papayapeter/nixie-clock/README.md

# nixie-clock
a nixie clock built around 4 IN-2 tubes and an INS-1 dot

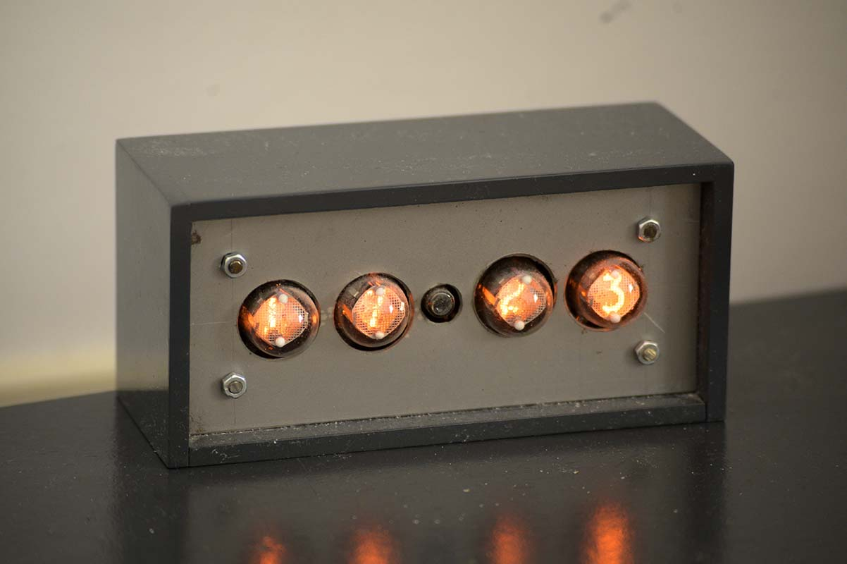
[picture p1: doc/_DSC0836.jpg]
front


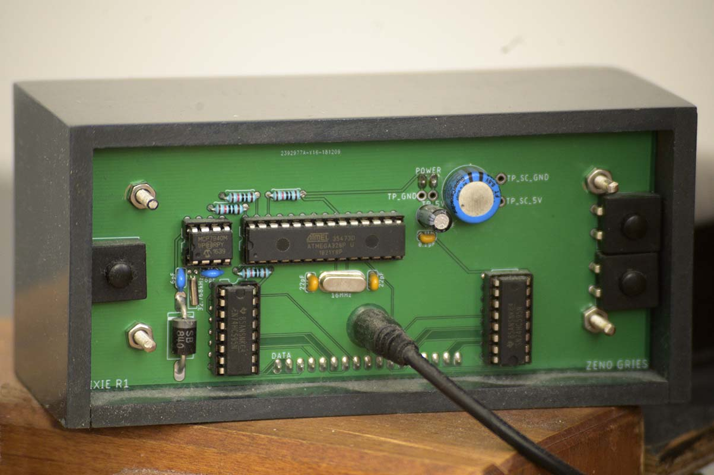
[picture p2: doc/_DSC0846.jpg]
back
