papayapeter/nixie-clock/eagle/HighVBoard_01.brd

## EAGLE design eagle/HighVBoard_01.brd (2019-07-09)

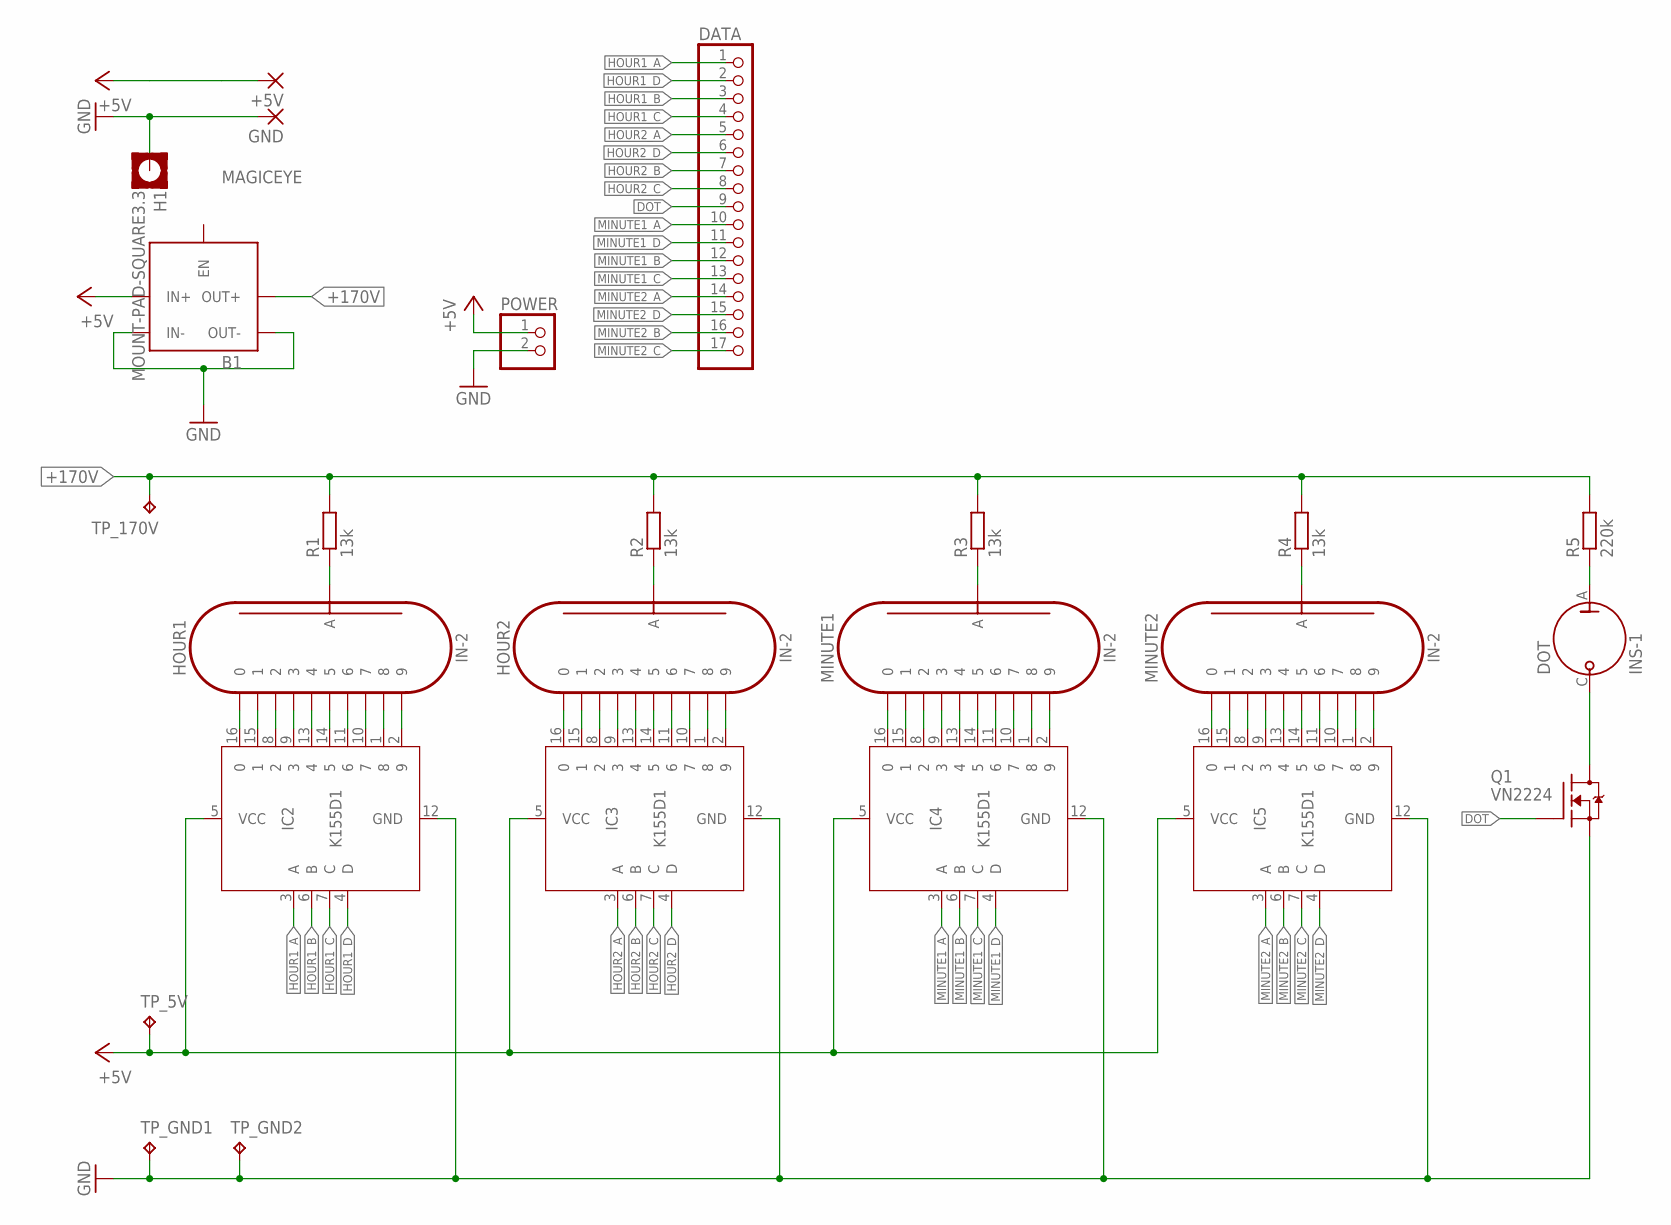
[picture p3: schematic HighVBoard_01.sch]

Parts:
+5V: 2,15/1,0
B1: MAGICEYE
DATA: PINHD-1X17; 1X17
DOT: INS-1
GND: 2,15/1,0
H1: MOUNT-PAD-SQUARE3.3; 3,3-PAD-SQUARE
HOUR1, HOUR2: IN-2
IC2, IC3, IC4, IC5: K155D1; DIL16
MINUTE1, MINUTE2: IN-2
POWER: PINHD-1X2; 1X02
Q1: VN2224; TO92
R1, R2, R3, R4: 13k; 0207/10
R5: 220k; 0207/10
TP_5V, TP_170V: TPPAD1-13; P1-13
TP_GND1, TP_GND2: TPPAD1-13; P1-13

Connections:
+5V: +5V.1, B1.IN+, IC2.5 (VCC), IC3.5 (VCC), IC4.5 (VCC), IC5.5 (VCC), POWER.1, TP_5V.TP
+170V: B1.OUT+, R1.2, R2.2, R3.2, R4.2, R5.2, TP_170V.TP
DOT: DATA.9, Q1.2 (G)
GND: B1.IN-, B1.OUT-, GND.1, H1.B3,3, IC2.12 (GND), IC3.12 (GND), IC4.12 (GND), IC5.12 (GND), POWER.2, Q1.1 (S), TP_GND1.TP, TP_GND2.TP
HOUR1_A: DATA.1, IC2.3 (A)
HOUR1_B: DATA.3, IC2.6 (B)
HOUR1_C: DATA.4, IC2.7 (C)
HOUR1_D: DATA.2, IC2.4 (D)
HOUR2_A: DATA.5, IC3.3 (A)
HOUR2_B: DATA.7, IC3.6 (B)
HOUR2_C: DATA.8, IC3.7 (C)
HOUR2_D: DATA.6, IC3.4 (D)
MINUTE1_A: DATA.10, IC4.3 (A)
MINUTE1_B: DATA.12, IC4.6 (B)
MINUTE1_C: DATA.13, IC4.7 (C)
MINUTE1_D: DATA.11, IC4.4 (D)
MINUTE2_A: DATA.14, IC5.3 (A)
MINUTE2_B: DATA.16, IC5.6 (B)
MINUTE2_C: DATA.17, IC5.7 (C)
MINUTE2_D: DATA.15, IC5.4 (D)
unnamed: DOT.C, Q1.3 (D)
unnamed: HOUR1.0, IC2.16 (0)
unnamed: HOUR1.1, IC2.15 (1)
unnamed: HOUR1.2, IC2.8 (2)
unnamed: HOUR1.3, IC2.9 (3)
unnamed: HOUR1.4, IC2.13 (4)
unnamed: HOUR1.5, IC2.14 (5)
unnamed: HOUR1.6, IC2.11 (6)
unnamed: HOUR1.7, IC2.10 (7)
unnamed: HOUR1.8, IC2.1 (8)
unnamed: HOUR1.9, IC2.2 (9)
unnamed: HOUR1.A, R1.1
unnamed: HOUR2.0, IC3.16 (0)
unnamed: HOUR2.1, IC3.15 (1)
unnamed: HOUR2.2, IC3.8 (2)
unnamed: HOUR2.3, IC3.9 (3)
unnamed: HOUR2.4, IC3.13 (4)
unnamed: HOUR2.5, IC3.14 (5)
unnamed: HOUR2.6, IC3.11 (6)
unnamed: HOUR2.7, IC3.10 (7)
unnamed: HOUR2.8, IC3.1 (8)
unnamed: HOUR2.9, IC3.2 (9)
unnamed: HOUR2.A, R2.1
unnamed: IC4.16 (0), MINUTE1.0
unnamed: IC4.15 (1), MINUTE1.1
unnamed: IC4.8 (2), MINUTE1.2
unnamed: IC4.9 (3), MINUTE1.3
unnamed: IC4.13 (4), MINUTE1.4
unnamed: IC4.14 (5), MINUTE1.5
unnamed: IC4.11 (6), MINUTE1.6
unnamed: IC4.10 (7), MINUTE1.7
unnamed: IC4.1 (8), MINUTE1.8
unnamed: IC4.2 (9), MINUTE1.9
unnamed: MINUTE1.A, R3.1
unnamed: IC5.16 (0), MINUTE2.0
unnamed: IC5.15 (1), MINUTE2.1
unnamed: IC5.8 (2), MINUTE2.2
unnamed: IC5.9 (3), MINUTE2.3
unnamed: IC5.13 (4), MINUTE2.4
unnamed: IC5.14 (5), MINUTE2.5
unnamed: IC5.11 (6), MINUTE2.6
unnamed: IC5.10 (7), MINUTE2.7
unnamed: IC5.1 (8), MINUTE2.8
unnamed: IC5.2 (9), MINUTE2.9
unnamed: MINUTE2.A, R4.1
unnamed: DOT.A, R5.1

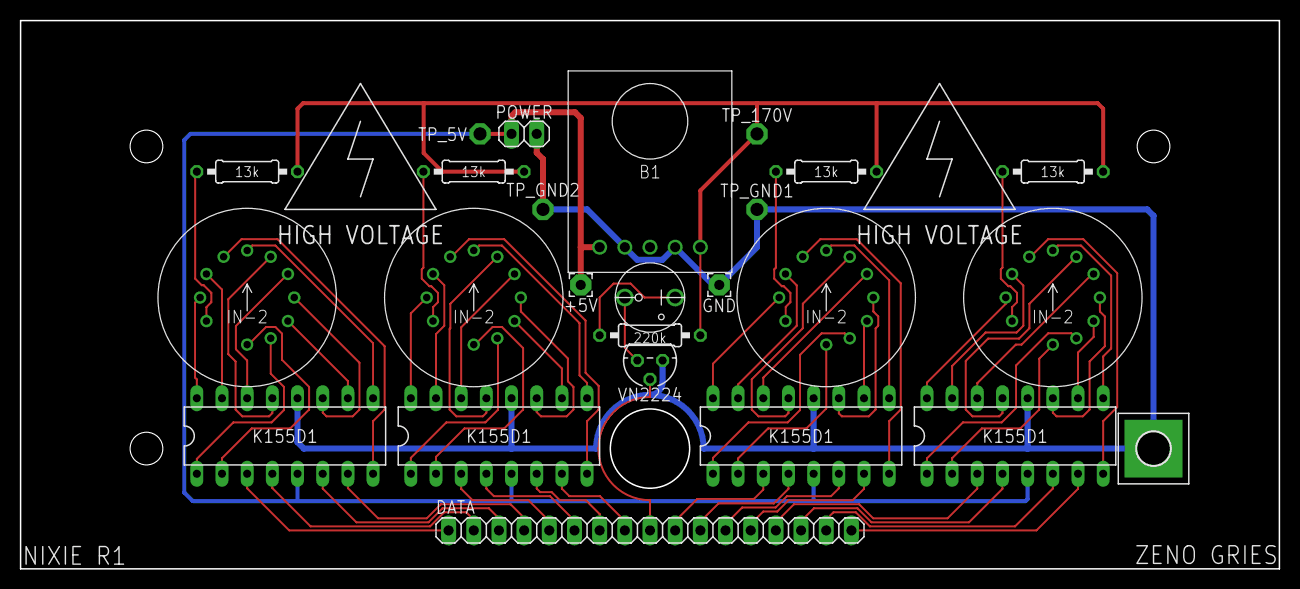
[picture p4: board HighVBoard_01.brd from above]

Board: 2 copper layers, 127.0 x 55.3 mm, 25 parts (0 on the bottom side), 66 nets.
