papayapeter/nixie-clock/eagle/LowVBoard_01.brd

## EAGLE design eagle/LowVBoard_01.brd (2019-07-09)

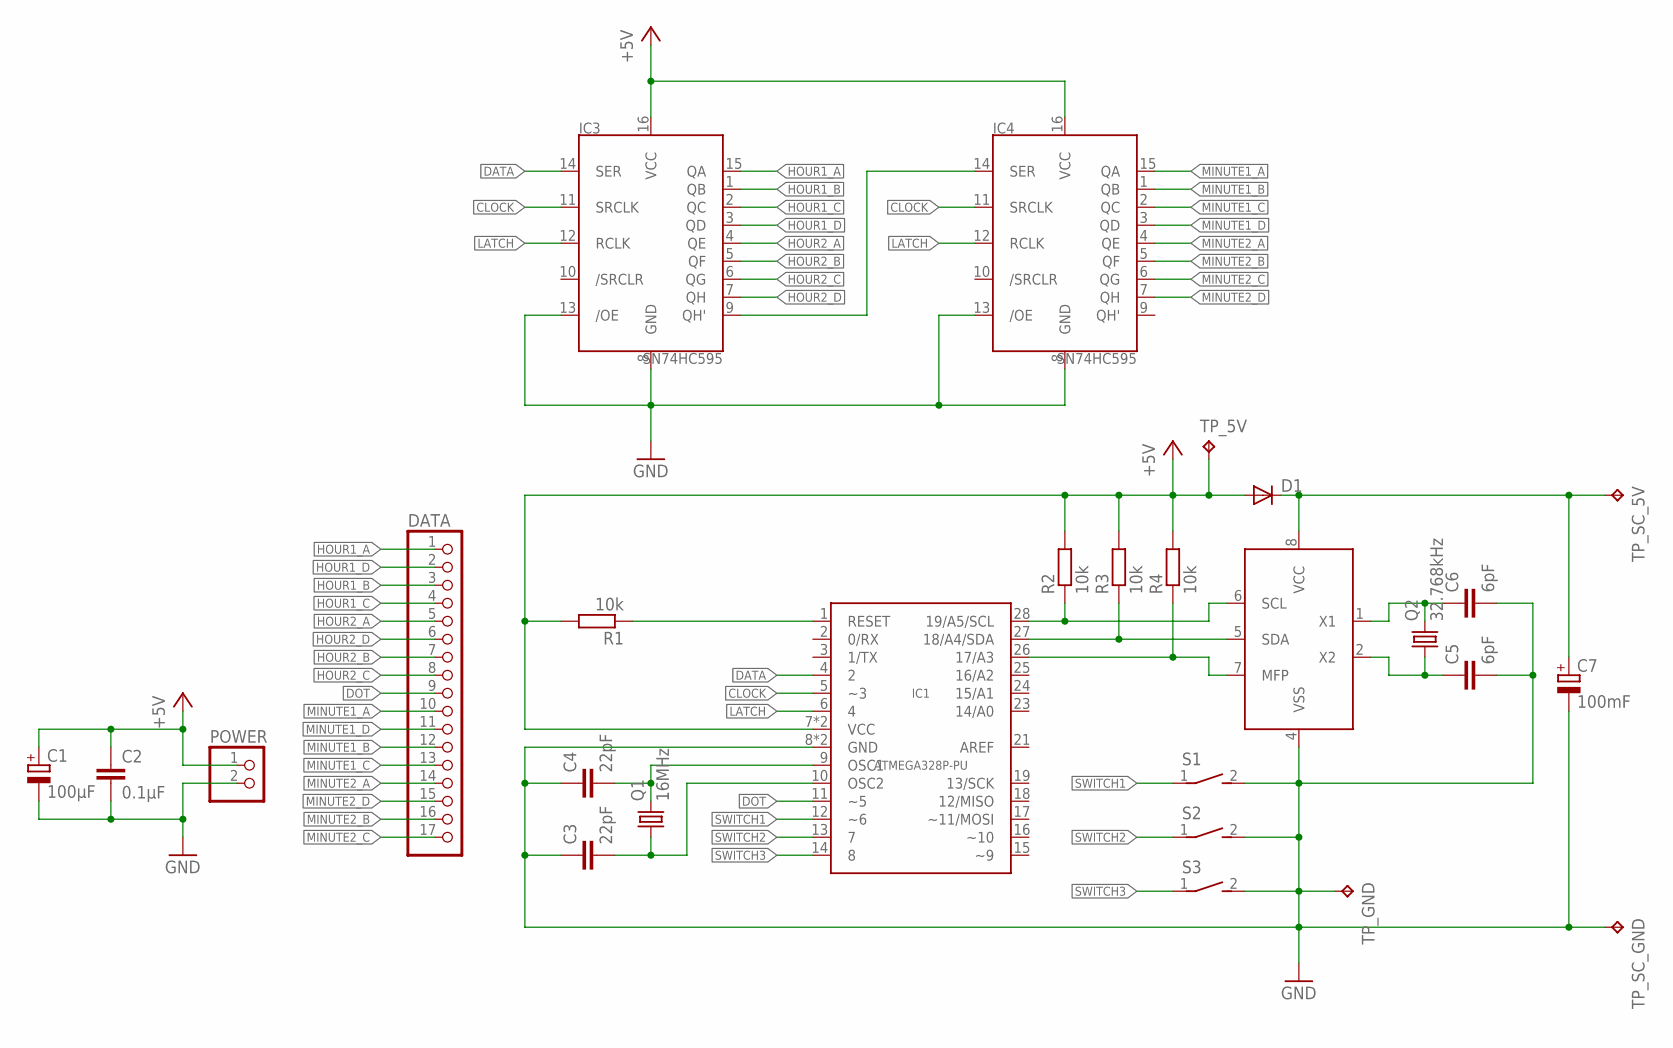
[picture p5: schematic LowVBoard_01.sch]

Parts:
C1: 100µF; E2-5
C2: 0.1µF; C025-024X044
C3, C4: 22pF; C025-024X044
C5, C6: 6pF; C025-024X044
C7: 100mF; SUPERCAP-11.5
D1: DIODE-DO201-15; DO201-15
DATA: PINHD-1X17; 1X17
IC1: ATMEGA328P-PU; DIP28
IC2: MCP7940M; DIL8
IC3, IC4: SN74HC595; DIL16
POWER: PINHD-1X2; 1X02
Q1: 16MHz; HC49/S
Q2: 32.768kHz; CFS-206
R1, R2, R3, R4: 10k; 0207/7
S1, S2, S3: GPTS203211B
TP_5V: TPPAD1-13; P1-13
TP_GND: TPPAD1-13; P1-13
TP_SC_5V: TPPAD1-13; P1-13
TP_SC_GND: TPPAD1-13; P1-13

Connections:
+5V: C1.+, C2.1, D1.A, IC1.7 (VCC), IC1.20 (VCC), IC3.16 (VCC), IC4.16 (VCC), POWER.1, R1.2, R2.2, R3.2, R4.2, TP_5V.TP
CLOCK: IC1.5 (~3), IC3.11 (SRCLK), IC4.11 (SRCLK)
DATA: IC1.4 (2), IC3.14 (SER)
DOT: DATA.9, IC1.11 (~5)
GND: C1.-, C2.2, C3.1, C4.1, C5.2, C6.2, C7.-, IC1.8 (GND), IC1.22 (GND), IC2.4 (VSS), IC3.8 (GND), IC3.13 (/OE), IC4.8 (GND), IC4.13 (/OE), POWER.2, S1.2 (S), S2.2 (S), S3.2 (S), TP_GND.TP, TP_SC_GND.TP
HOUR1_A: DATA.1, IC3.15 (QA)
HOUR1_B: DATA.3, IC3.1 (QB)
HOUR1_C: DATA.4, IC3.2 (QC)
HOUR1_D: DATA.2, IC3.3 (QD)
HOUR2_A: DATA.5, IC3.4 (QE)
HOUR2_B: DATA.7, IC3.5 (QF)
HOUR2_C: DATA.8, IC3.6 (QG)
HOUR2_D: DATA.6, IC3.7 (QH)
LATCH: IC1.6 (4), IC3.12 (RCLK), IC4.12 (RCLK)
MINUTE1_A: DATA.10, IC4.15 (QA)
MINUTE1_B: DATA.12, IC4.1 (QB)
MINUTE1_C: DATA.13, IC4.2 (QC)
MINUTE1_D: DATA.11, IC4.3 (QD)
MINUTE2_A: DATA.14, IC4.4 (QE)
MINUTE2_B: DATA.16, IC4.5 (QF)
MINUTE2_C: DATA.17, IC4.6 (QG)
MINUTE2_D: DATA.15, IC4.7 (QH)
unnamed: C7.+, D1.C, IC2.8 (VCC), TP_SC_5V.TP
unnamed: C4.2, IC1.9 (OSC1), Q1.2
unnamed: C3.2, IC1.10 (OSC2), Q1.1
unnamed: IC1.1 (RESET), R1.1
unnamed: IC1.28 (19/A5/SCL), IC2.6 (SCL), R2.1
unnamed: IC1.27 (18/A4/SDA), IC2.5 (SDA), R3.1
unnamed: IC1.26 (17/A3), IC2.7 (MFP), R4.1
unnamed: C6.1, IC2.1 (X1), Q2.P$2 (2)
unnamed: C5.1, IC2.2 (X2), Q2.P$1 (1)
unnamed: IC3.9 (QH'), IC4.14 (SER)
SWITCH1: IC1.12 (~6), S1.1
SWITCH2: IC1.13 (7), S2.1
SWITCH3: IC1.14 (8), S3.1

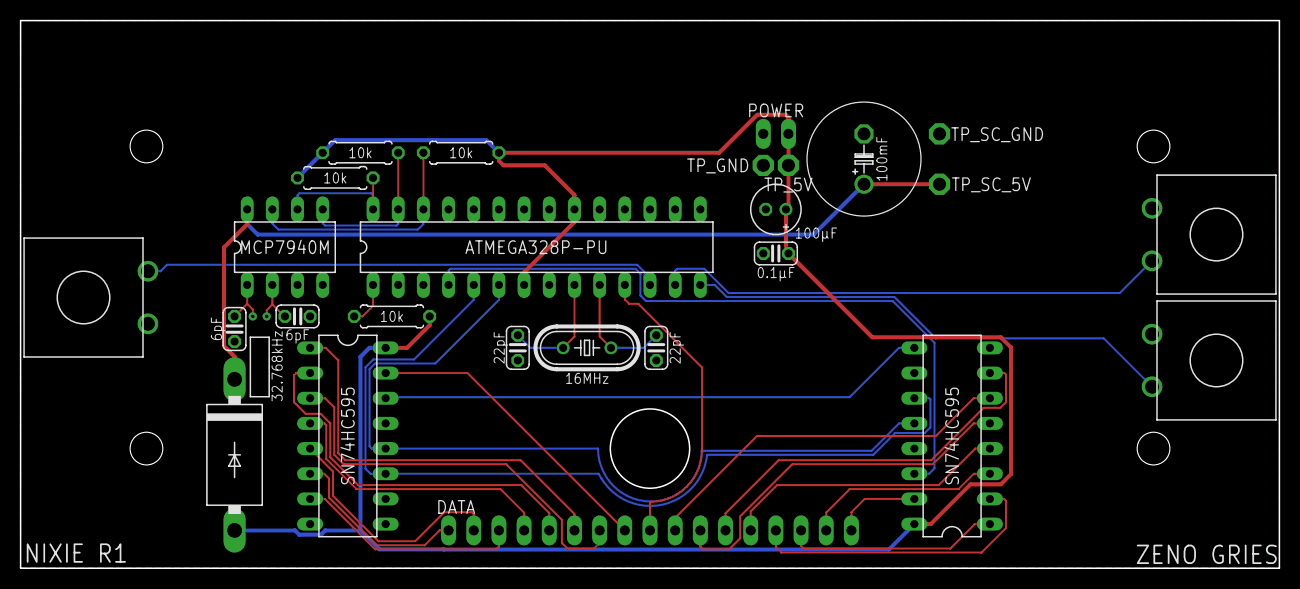
[picture p6: board LowVBoard_01.brd from above]

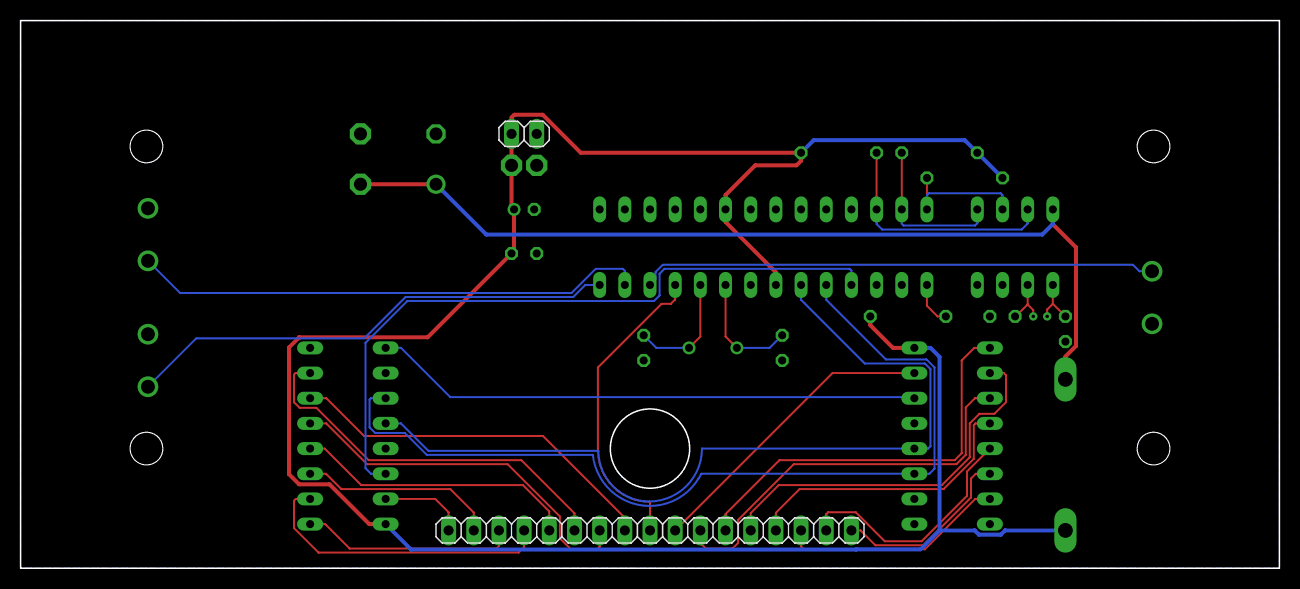
[picture p7: board LowVBoard_01.brd from below]

Board: 2 copper layers, 127.0 x 55.2 mm, 27 parts (2 on the bottom side), 35 nets.
