papayapeter/nixie-clock/atmega328p/clock.cpp

#include "clock.h"

// methods ---------------------------------------------------------------------
void Clock::init(uint8_t data, uint8_t clock, uint8_t latch, uint8_t dot,
                 uint8_t switch_1, uint8_t switch_2, uint8_t switch_3, uint16_t debounce,
                 uint8_t tube_table[][4])
{
  // set variables
  pin_dot = dot;
  
  // transfer tube_table to member table
  for (uint8_t i = 0; i < 11; i++)
  {
    for (uint8_t j = 0; j < 4; j++)
      table[i][j] = tube_table[i][j];
  }

  // set pin mode
  pinMode(pin_dot, OUTPUT);

  // set debounced buttons
  button_1.attach(switch_1, INPUT_PULLUP);
  button_2.attach(switch_2, INPUT_PULLUP);
  button_3.attach(switch_3, INPUT_PULLUP);
  button_1.interval(debounce);
  button_2.interval(debounce);
  button_3.interval(debounce);

  // initialize shift registers
  shift.setBitCount(16);
  shift.setPins(data, clock, latch);

  // set diplay to zero with dot on
  this->display(0, 0);
  digitalWrite(pin_dot, HIGH);

  // begin communication with rtc and start oscillator
  while (!real_time.begin())
  {
    // if cannot connect to rtc -> blink fast
    digitalWrite(pin_dot, HIGH);
    delay(500);
    digitalWrite(pin_dot, LOW);
    delay(500);

    // debug
    DEBUG_PRINTLN("cannot connect. reattempting...");
  }
  // if connected -> turn dot on and start rtc
  real_time.deviceStart();
  digitalWrite(pin_dot, HIGH);

  // debug
  DEBUG_PRINTLN("connected");

  // update and display the time
  this->updateTime();
  this->display();
}

bool Clock::updateTime()
{
  // get time from rtc
  now = real_time.now();

  // debug
  DEBUG_PRINTLN("H: " + String(now.hour()) +
              "\tM: " + String(now.minute()) +
              "\tS: " + String(now.second()));

  // return true if time has changed
  if (now.minute() != last.minute() || now.hour() != last.hour()) // if time changed
  {
    last = now;
    return true;
  }

  return false;
}

void Clock::setTime(uint8_t hour, uint8_t minute)
{
  real_time.adjust(DateTime(2019, 3, 23, hour, minute, 0));
}

uint8_t Clock::getMinute()
{
  return now.minute();
}

uint8_t Clock::getHour()
{
  return now.hour();
}

uint8_t Clock::updateButtons()
{
  button_1.update();
  button_2.update();
  button_3.update();

  if (button_1.rose() || button_1.fell()) return pressed_1;
  if (button_2.rose() || button_2.fell()) return pressed_2;
  if (button_3.rose() || button_3.fell()) return pressed_3;
  return 0;
}

bool Clock::evenSecond()
{
  if (now.second() % 2 == 0) return true;
  else                       return false;
}

void Clock::setDot(bool state)
{
  if (state) digitalWrite(pin_dot, HIGH);
  else       digitalWrite(pin_dot, LOW);
}

bool Clock::display()
{
  return this->display(now.hour(), now.minute(), true, true);
}

bool Clock::display(uint8_t hour, uint8_t minute,
                    bool hour_on = true, bool minute_on = true)
{
  // test out of bounds
  if (hour > 99 || minute > 99)
  {
    return false;
  }

  uint8_t h_1;
  uint8_t h_2;
  uint8_t m_1;
  uint8_t m_2;
  // get single digits or turn display off
  if (hour_on)
  {
    h_1 = hour / 10;
    h_2 = hour % 10;
  }
  else
  {
    h_1 = 10;
    h_2 = 10;
  }
  if (minute_on)
  {
    m_1 = minute / 10;
    m_2 = minute % 10;
  }
  else
  {
    m_1 = 10;
    m_2 = 10;
  }

  shift.batchWriteBegin();

  // minute 1
  shift.writeBit(0, table[m_1][0]);
  shift.writeBit(1, table[m_1][1]);
  shift.writeBit(2, table[m_1][2]);
  shift.writeBit(3, table[m_1][3]);

  // minute 2
  shift.writeBit(4, table[m_2][0]);
  shift.writeBit(5, table[m_2][1]);
  shift.writeBit(6, table[m_2][2]);
  shift.writeBit(7, table[m_2][3]);

  // hour 1
  shift.writeBit(8, table[h_1][0]);
  shift.writeBit(9, table[h_1][1]);
  shift.writeBit(10, table[h_1][2]);
  shift.writeBit(11, table[h_1][3]);

  // hour 2
  shift.writeBit(12, table[h_2][0]);
  shift.writeBit(13, table[h_2][1]);
  shift.writeBit(14, table[h_2][2]);
  shift.writeBit(15, table[h_2][3]);

  shift.batchWriteEnd();

  return true;
}
